avenqo/frosch/hardware/kicad/nord/frosch-nord.pdf

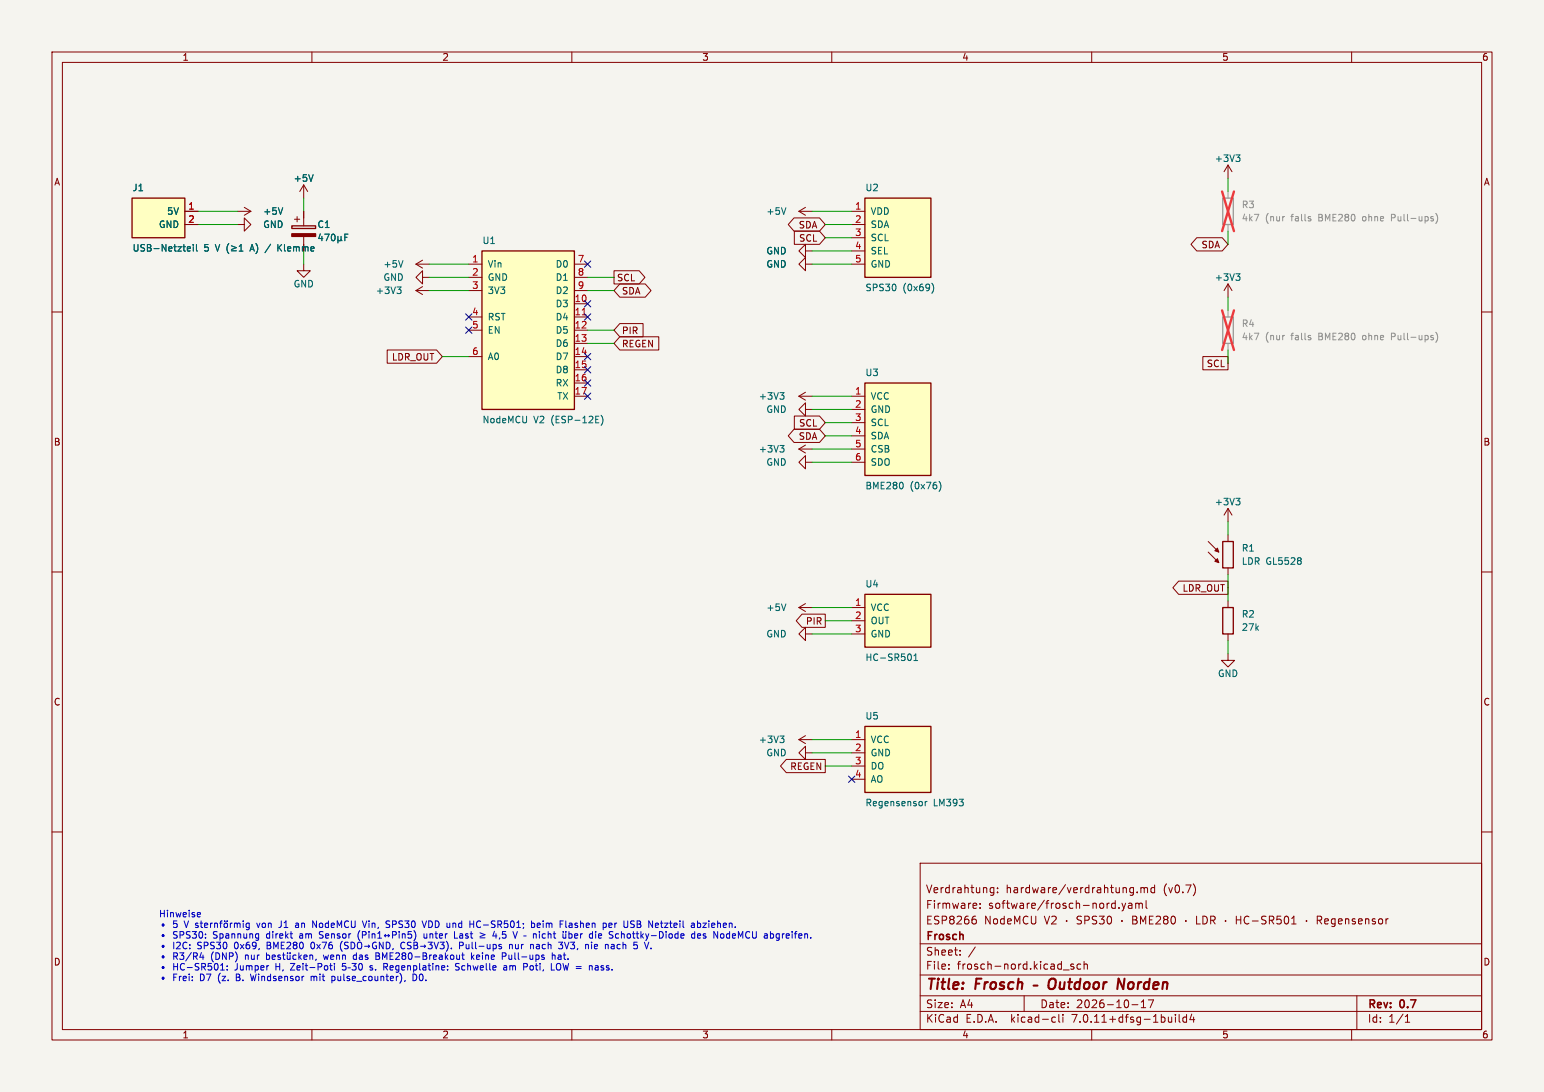
[picture p1: page 1]

VCC 1 OUT 2 GND 3 U4 HC-SR501 C1

4k7 (nur falls BME280 ohne Pull-ups) R4

4k7 (nur falls BME280 ohne Pull-ups) GND

Id: 1/1 Title: Frosch þÿ Outdoor Norden
