avenqo/frosch/hardware/kicad/wohnzimmer/frosch-wohnzimmer.pdf

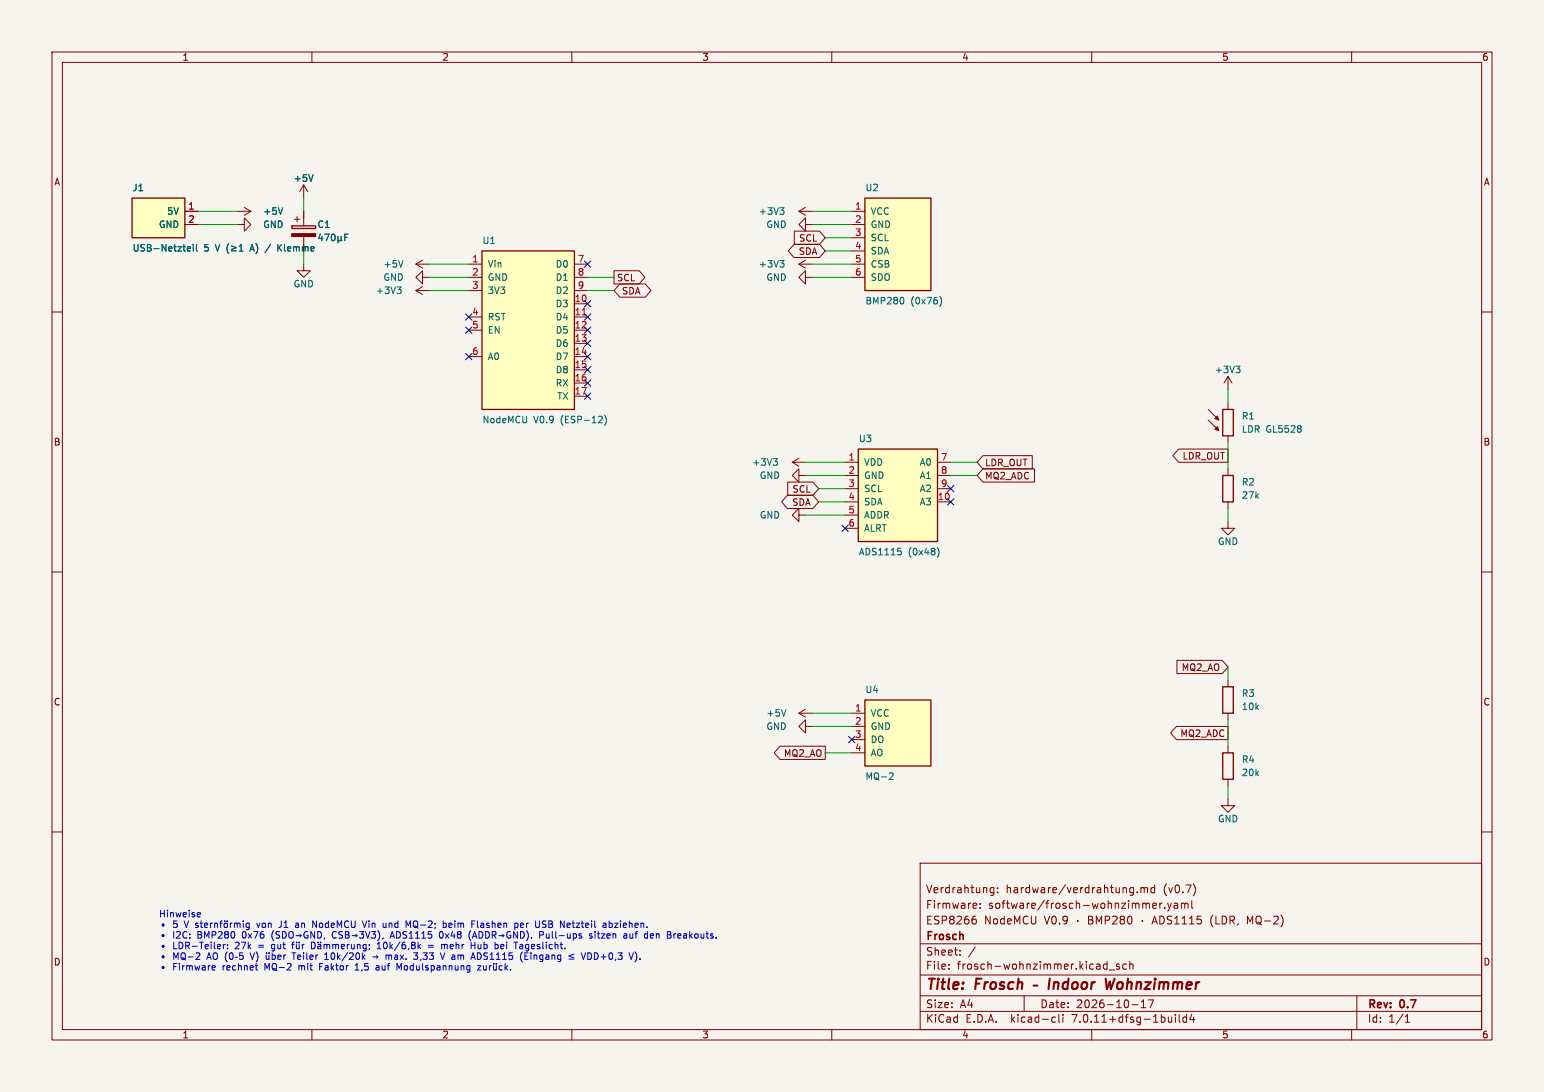
[picture p2: page 1]
