avenqo/frosch/hardware/kicad/nord/frosch-nord.kicad_sch

## KiCad design hardware/kicad/nord/frosch-nord.kicad_sch (2026-10-17)

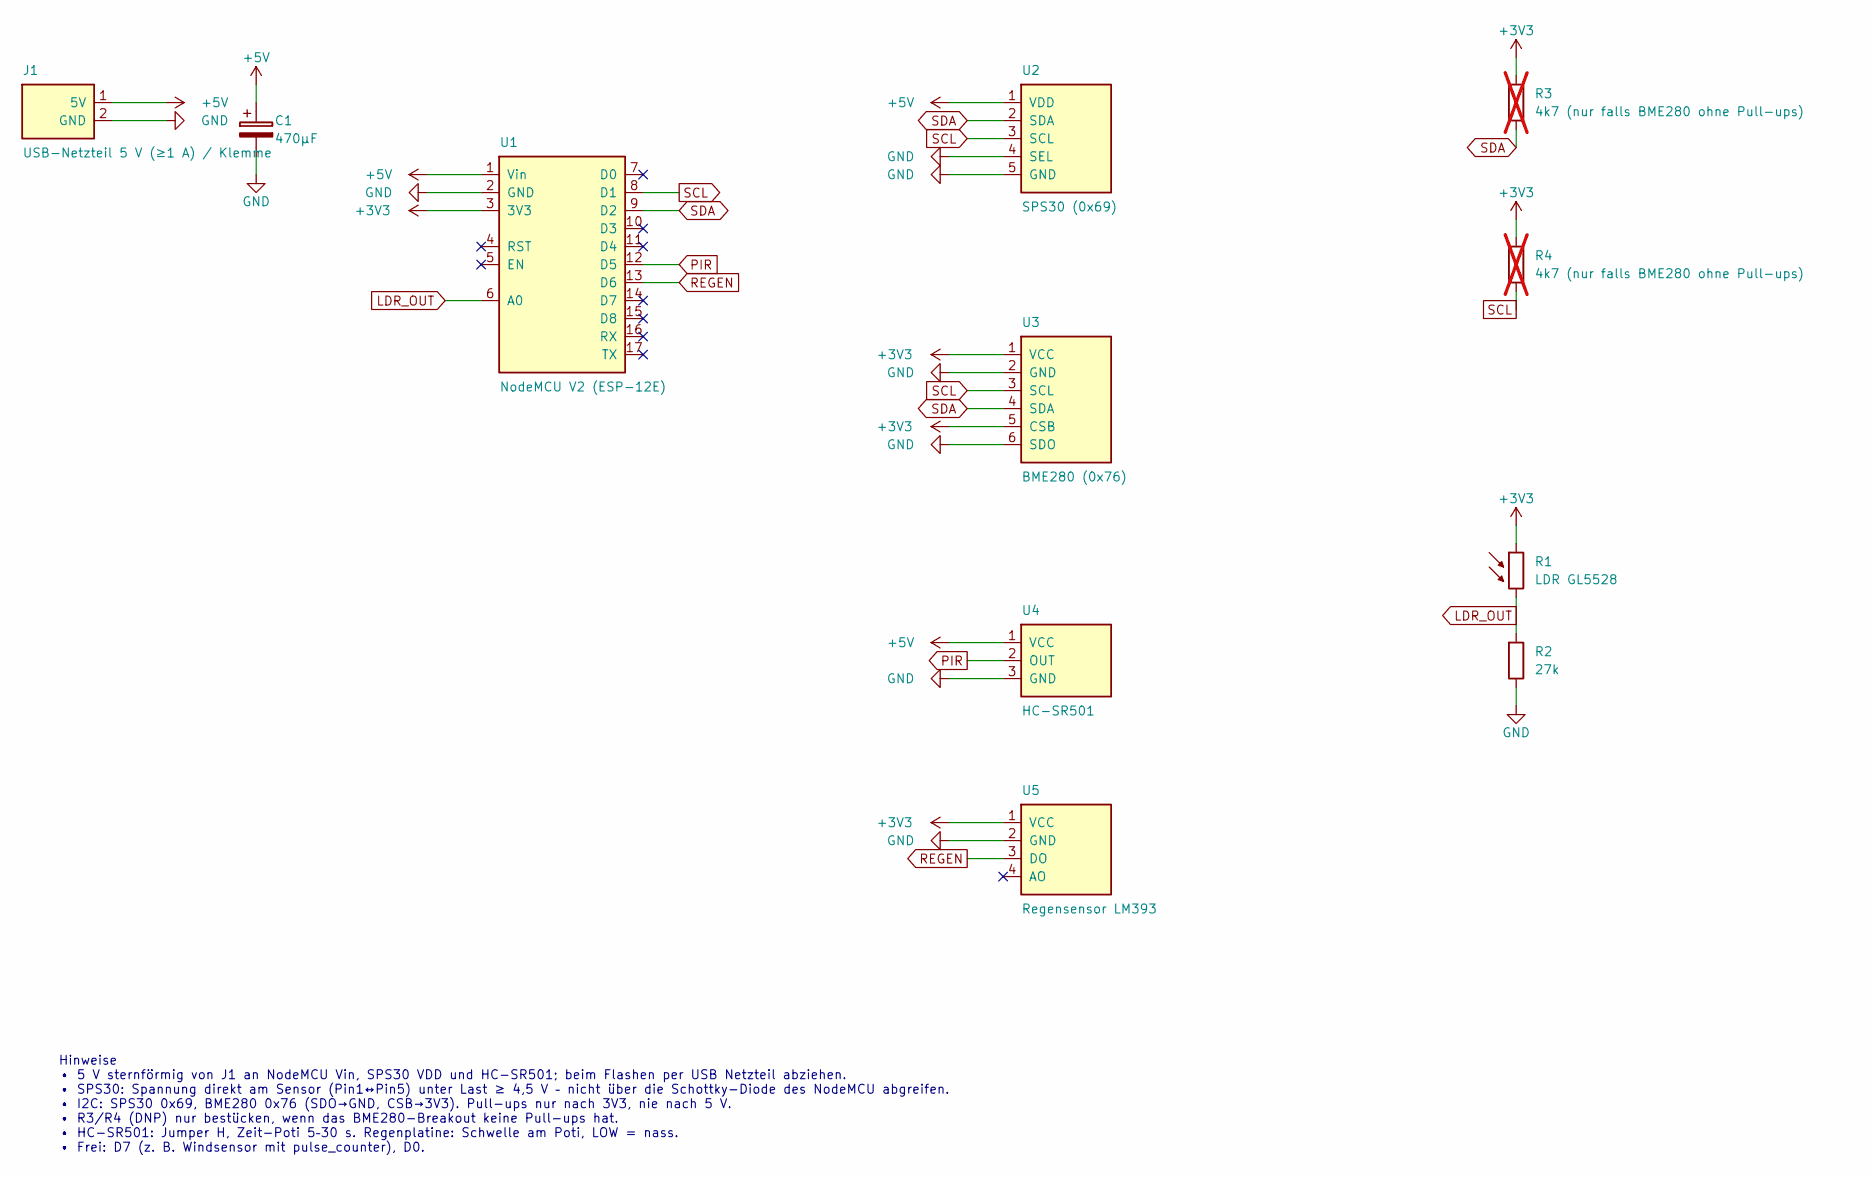
[picture p3: schematic frosch-nord.kicad_sch]

Parts:
C1: 470µF
J1: USB-Netzteil 5 V (≥1 A) / Klemme
R1: LDR GL5528
R2: 27k
R3, R4: 4k7 (nur falls BME280 ohne Pull-ups); not fitted
U1: NodeMCU V2 (ESP-12E)
U2: SPS30 (0x69)
U3: BME280 (0x76)
U4: HC-SR501
U5: Regensensor LM393

Connections:
+3V3: R1.1, R3.1, R4.1, U1.3 (3V3), U3.1 (VCC), U3.5 (CSB), U5.1 (VCC)
+5V: C1.1, J1.1 (5V), U1.1 (Vin), U2.1 (VDD), U4.1 (VCC)
GND: C1.2, J1.2 (GND), R2.2, U1.2 (GND), U2.4 (SEL), U2.5 (GND), U3.2 (GND), U3.6 (SDO), U4.3 (GND), U5.2 (GND)
LDR_OUT: R1.2, R2.1, U1.6 (A0)
PIR: U1.12 (D5), U4.2 (OUT)
REGEN: U1.13 (D6), U5.3 (DO)
SCL: R4.2, U1.8 (D1), U2.3 (SCL), U3.3 (SCL)
SDA: R3.2, U1.9 (D2), U2.2 (SDA), U3.4 (SDA)

Notes on the sheet:
Hinweise • 5 V sternförmig von J1 an NodeMCU Vin, SPS30 VDD und HC-SR501; beim Flashen per USB Netzteil abziehen. • SPS30: Spannung direkt am Sensor (Pin1↔Pin5) unter Last ≥ 4,5 V – nicht über die Schottky-Diode des NodeMCU abgreifen. • I2C: SPS30 0x69, BME280 0x76 (SDO→GND, CSB→3V3). Pull-ups nur 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
