avenqo/frosch/hardware/kicad/wohnzimmer/frosch-wohnzimmer.kicad_sch

## KiCad design hardware/kicad/wohnzimmer/frosch-wohnzimmer.kicad_sch (2026-10-23)

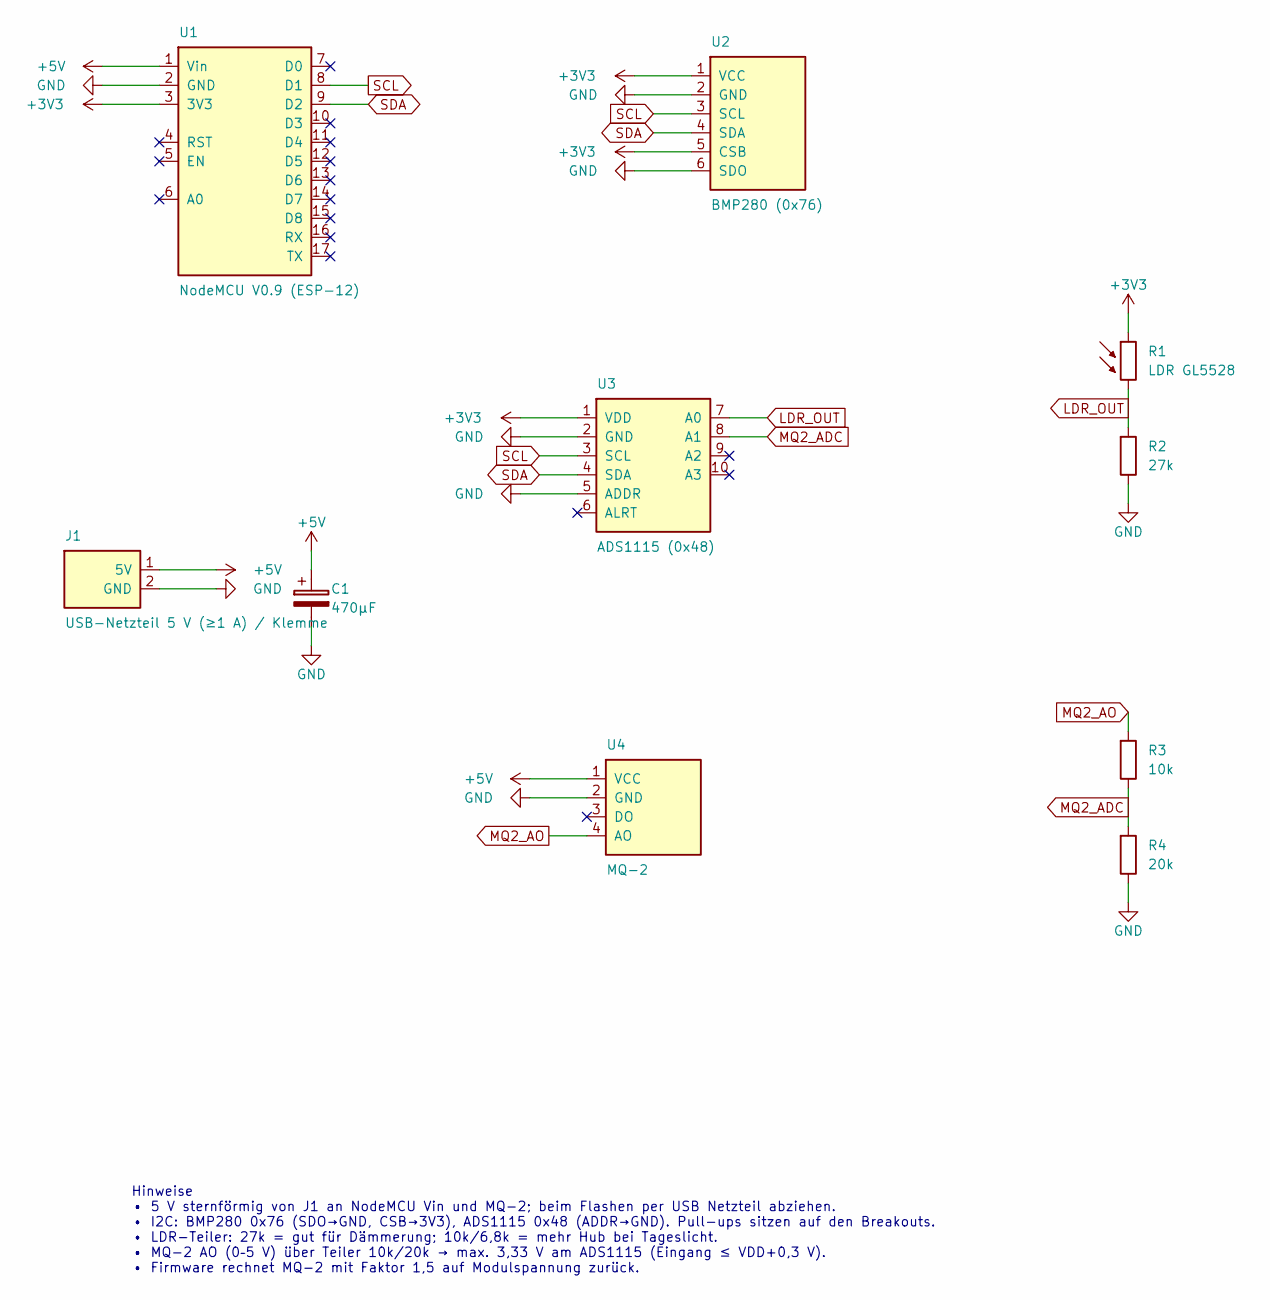
[picture p4: schematic frosch-wohnzimmer.kicad_sch]

Parts:
C1: 470µF
J1: USB-Netzteil 5 V (≥1 A) / Klemme
R1: LDR GL5528
R2: 27k
R3: 10k
R4: 20k
U1: NodeMCU V0.9 (ESP-12)
U2: BMP280 (0x76)
U3: ADS1115 (0x48)
U4: MQ-2

Connections:
+3V3: R1.1, U1.3 (3V3), U2.1 (VCC), U2.5 (CSB), U3.1 (VDD)
+5V: C1.1, J1.1 (5V), U1.1 (Vin), U4.1 (VCC)
GND: C1.2, J1.2 (GND), R2.2, R4.2, U1.2 (GND), U2.2 (GND), U2.6 (SDO), U3.2 (GND), U3.5 (ADDR), U4.2 (GND)
LDR_OUT: R1.2, R2.1, U3.7 (A0)
MQ2_ADC: R3.2, R4.1, U3.8 (A1)
MQ2_AO: R3.1, U4.4 (AO)
SCL: U1.8 (D1), U2.3 (SCL), U3.3 (SCL)
SDA: U1.9 (D2), U2.4 (SDA), U3.4 (SDA)

Notes on the sheet:
Hinweise • 5 V sternförmig von J1 an NodeMCU Vin und MQ-2; beim Flashen per USB Netzteil abziehen. • I2C: BMP280 0x76 (SDO→GND, CSB→3V3), ADS1115 0x48 (ADDR→GND). Pull-ups sitzen auf den Breakouts. • LDR-Teiler: 27k = gut für Dämmerung; 10k/6,8k = mehr Hub bei Tageslicht. • MQ-2 AO (0–5 V) über Tei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
