avenqo/frosch/(commit log)

2026-10-17 wip kicad
    [frosch-nord.kicad_sch, frosch-wohnzimmer.kicad_sch]
2026-10-23 motion sensor added
    [frosch-wohnzimmer.kicad_sch]
